1ismai1/imu-logger-stm32/docs/captures/01_i2c_burst_read_timing.png

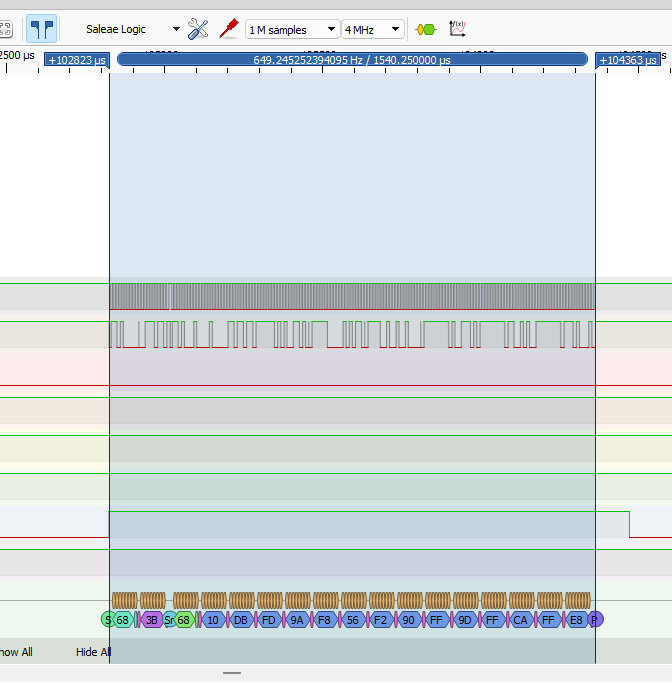
docs/captures/01_i2c_burst_read_timing.png
