1ismai1/imu-logger-stm32/docs/captures/03a_spi_clock_period.png

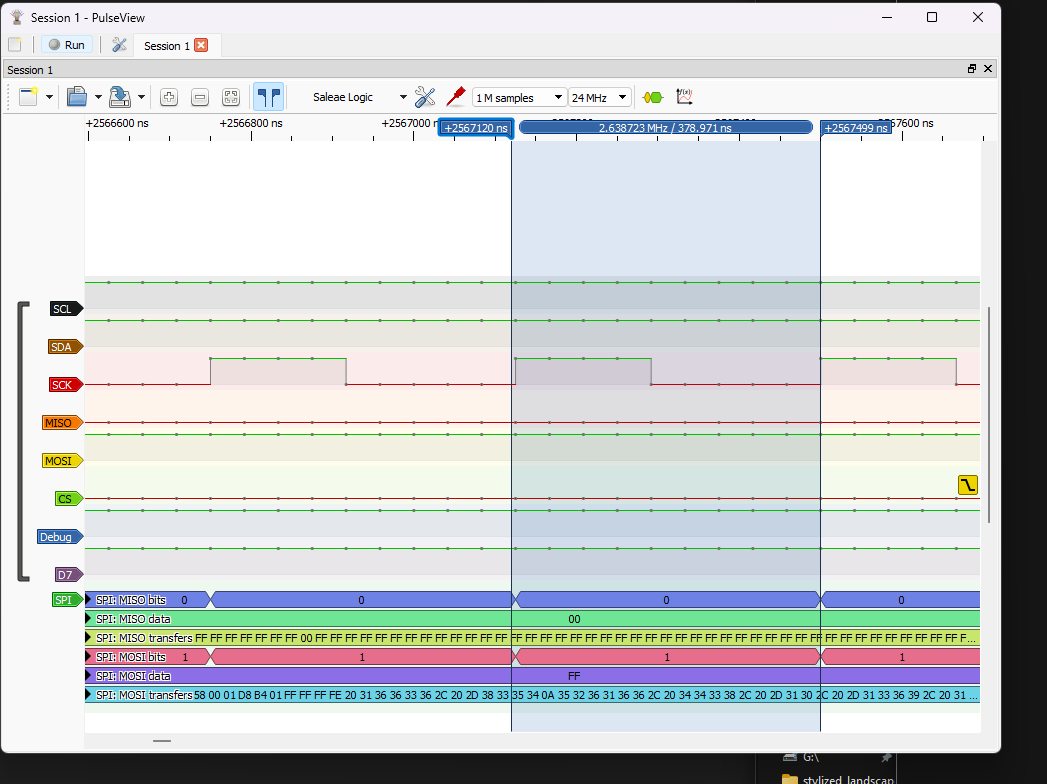
docs/captures/03a_spi_clock_period.png
