1ismai1/imu-logger-stm32/docs/captures/03b_sd_card_busy.png

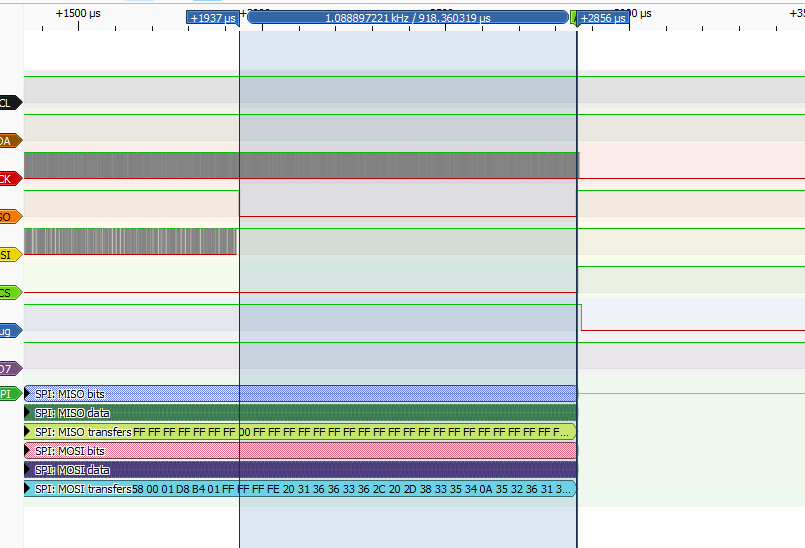
docs/captures/03b_sd_card_busy.png
