1ismai1/imu-logger-stm32/docs/captures/02b_loop_timing_fsync_2.6MHz_test.png

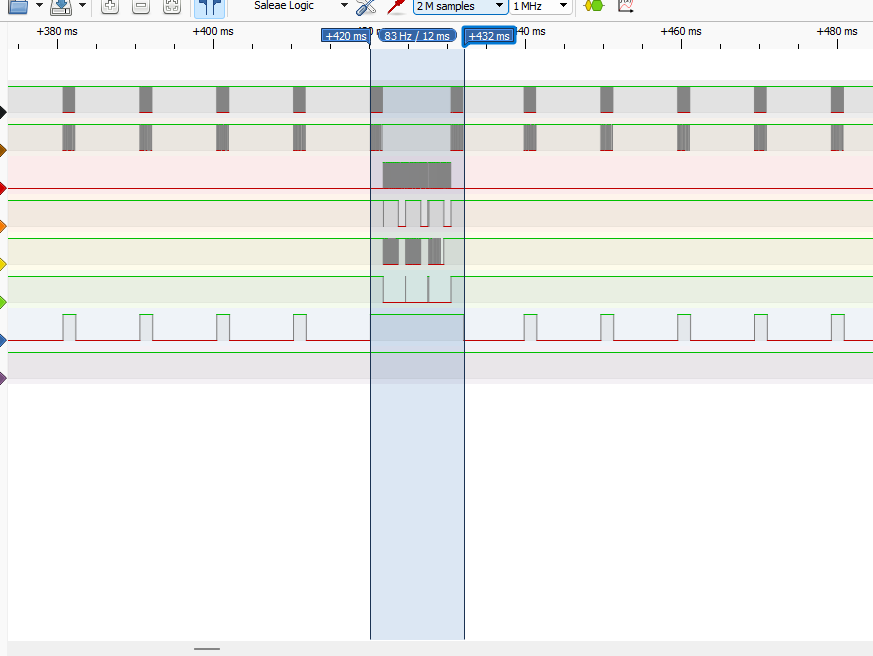
docs/captures/02b_loop_timing_fsync_2.6MHz_test.png
