1ismai1/imu-logger-stm32/(commit log)

2026-09-12 I2C peripheral setup
2026-09-17 I2C master working: primitives, probe and SWRST fix
    [IMULogger.ioc, main.c]
2026-09-18 I2C: moved to PB8/PB9, added a NACK escape, MPU-6050 read X acceleration
2026-09-20 ADD I2C burst read for MPU-6050 14 byte sensor block
2026-09-21 IMU: unit conversion, range config, calibration, sendFloat function; Stopped tracking Debug/
2026-09-22 IMU: added complementary filter, accounted for error in acc_angle & added pitch reading
    - compared gyroscope and accelerometer readings to get most optimal blend between the two.
    - added a pitch angle as well
    [main.c]
2026-09-24 Add SPI1 driver and SD card init (CMD0, CMD8, ACMD41, CMD58)
    - tested to see if i had a new or old sd card to see what voltage the card runs on
    -added a start up check to prevent sending out data while card is not ready
    - checked whether my card was SDHC or a smaller sd card
    [main.c]
2026-09-24 Added SD block read and sped up SPI to 10.5 MHz
    - sd_init() runs once at startup, returns error code per step
    - Read block 0, verified 0x55AA signature
    - Original card was faulty, switched to SanDisk 128GB
    [main.c]
2026-09-26 Log IMU data to CSV at 100 Hz
    - 1 ms SysTick interrupt drives a fixed 10 ms loop and timestamps
    - LOG.CSV: raw accel/gyro counts + roll/pitch x100, f_sync once per second
    - Gyro range raised to +/-2000 dps, accel to +/-8 g (both saturated while shaking)
    - Wrap roll angle into +/-180 deg
    - Verified: 320 s hard-shake log, roll stays in range, gyro no longer saturates
    [ffconf.h, main.c]
2026-09-26 Add pitch filter, numbered log files, SD recovery
    - Pitch complementary filter on Y gyro (sign verified), clamped to +/-90
    - Both filters start at the accel angle (no 2 s warm-up)
    - Each boot writes the next free LOGnnn.CSV instead of overwriting
    - sd_init drains a stuck read and waits out a busy card before CMD0
    - Fix PA6 pull-up (PUPDR was 11 = reserved, now 01)
    - Stop if no log file opens; remove old block test and unused code
    [main.c]
2026-09-26 Bounded I2C waits; recover from sensor disconnect
    - i2c_wait(): every I2C wait gives up after ~2 ms (uses ms_ticks)
    - I2C and MPU functions return 1/0; mpu_init() wakes sensor + sets ranges
    - On a failed read: reset I2C, re-init sensor, restart schedule, re-snap filters
    - All-zero accel = sensor asleep after power loss -> treated as a failure
    - Verified: SDA and sensor power unplugged ~4 s each, logging resumed
    [main.c]
2026-09-26 Finished and logged my imu logger with a .py plot
    [filter_demo.CSV]
2026-09-26 changed wiring on README
2026-09-29 Add logic-analyzer captures and PA8 debug timing pin
    - Add debug_pin_init(): PA8 (D7) goes high at the start of each loop
    pass and low at the end, so loop timing is visible on a logic analyzer
    - Restore SPI to /8 = 10.5 MHz after sd_init (was temporarily /32 for
    capture decoding) and fix the comment
    - Add docs/captures/: PulseView .sr/.pvs files and screenshots
    Measured results:
    - I2C: 100 kHz SCL, full 14-byte burst read = 1.54 ms, ACK/NACK/STOP
    sequence verified byte by byte
    - SPI: CMD24 block write decoded, data response 0xE5, card busy ~0.9 ms
    - Loop: normal pass ~1.65 ms of 10 ms; once-per-second f_sync pass
    5.3 ms at 10.5 MHz
    [main.c]
2026-10-04 Sample IMU from TIM2 interrupt into a ring buffer
    TIM2 fires every 10 ms and burst-reads the MPU-6050 into a 256-slot
    ring buffer; the main loop drains it to the SD card. Tracks max fill
    and dropped samples, printed once per second.
2026-10-05 Split logger into imu, filter and sd tasks joined by queues
    - imu_task (prio 40): vTaskDelayUntil every 10 ms, burst read,
    recovers the sensor itself (only task touching I2C)
    - filter_task (prio 32): scaling + complementary filter
    - sd_task (prio 16): CSV writes, f_sync + stats once a second
    - imu_q (16) and log_q (64) replace the hand-written ring buffer;
    TIM2 sampling interrupt removed
    - Verified on hardware: imuq 1 logq 1 drop 0/0 fault 0
2026-10-05 Report stats by time, measure stack high-water marks
    - sd_task saves + prints stats every 1 s of time (was every 100 rows),
    so the UART keeps reporting while the sensor is unplugged
    - Every 10 s: least-ever free stack per task + least-ever free heap
    - PA9 (D8) high during f_sync for logic-analyzer captures
    - Measured: stack free imu 212/256, filter 416/512, sd 892/1024,
    hb 100/128 words; heap min free 5440 B
2026-10-05 CubeMX: clock from ST-LINK 8 MHz (HSE bypass), stack overflow check
    Generated code only. HSI measured ~1.5% fast on the logic analyzer
    (20 IMU periods = 197 ms). PLL now HSE/4*168/4 = 84 MHz, same bus
    speeds as before. configCHECK_FOR_STACK_OVERFLOW = 2.
2026-10-05 Size task stacks from measured use, report stack overflows
    - Stacks: imu 256->128, filter 512->256, sd 1024->512 words
    (measured use 44 / 96 / ~132 words; 2.7-3.9x margin)
    - vApplicationStackOverflowHook prints the task name, then halts
    - Verified on hardware: free imu 84, filter 160, sd 382 words;
    heap min free 5440 -> 9024 B; drop 0/0
2026-10-05 Add FreeRTOS logic-analyzer captures
    - 04a: IMU read (D7) firing on schedule inside a ~10.6 ms f_sync (D8)
    - 04b: 20 IMU periods = 200.11 ms after switching to HSE; raw .sr
    shows periods of 10.000-10.001 ms and reads of 1.554 ms
2026-10-05 README: FreeRTOS architecture, stack sizing, new measurements
    - Architecture section: 3 tasks, 2 queues, priorities, design rules
    - Stack sizing from high-water marks (freed 3.5 KB of heap)
    - Preemption capture, clock-accuracy fix, sensor unplug test
    - Wiring adds PA9/PA10 debug pins; log format, serial output,
    bugs, limitations and roadmap brought up to date
2026-10-10 Move I2C and SD writes to DMA, add ping-pong SD buffers
    - I2C1 RX on DMA1 Stream 5 (ch 1): imu_task sleeps while the 14-byte
    burst read arrives; LAST bit NACKs the final byte, STOP sent in the ISR
    - SPI1 TX on DMA2 Stream 3 (ch 3): 512-byte SD blocks sent by DMA,
    task woken by the transfer-complete interrupt (task notification)
    - sd_task split into formatter (sd) + writer (sdw) with two 512-byte
    blocks swapped through free_q/full_q; block-aligned writes let FatFS
    pass the buffer straight to disk_write
    - SD card-busy wait sleeps 1 ms between checks instead of spinning
    - New stats: blk / wait / sderr; stacks sized from measurement
    - Tested on hardware: 0 drops, 0 SD errors, unplug test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
2026-10-10 README: DMA hardware test results and real serial output
2026-10-10 Add sensor vibration filter, measure gyro bias at boot, SPI DMA on Stream 3
    - MPU-6050 DLPF set to 44/42 Hz (CONFIG 0x1A = 3) so vibration above the
    50 Hz Nyquist limit can't alias into the 100 Hz samples
    - filter_task averages 2 s of still gyro samples at boot for the bias;
    retries if the board moves, falls back to stored values after 5 tries
    - SPI1 TX DMA moved from DMA2 Stream 5 to Stream 3 (ch 3) to keep
    Stream 5 free for USART1_RX (ESP32 link)
    - Tested on hardware: bias -92/-47/-11, 0 drops, 0 SD errors
2026-11-11 Shield v1 bring-up
    SD power enable, card detect, move debug pins off USART1, reset-cause print
